smlara/AstroK_Enfocador_Rotador/docs/ESP32-C3-Super-Mini-pinout-low.png

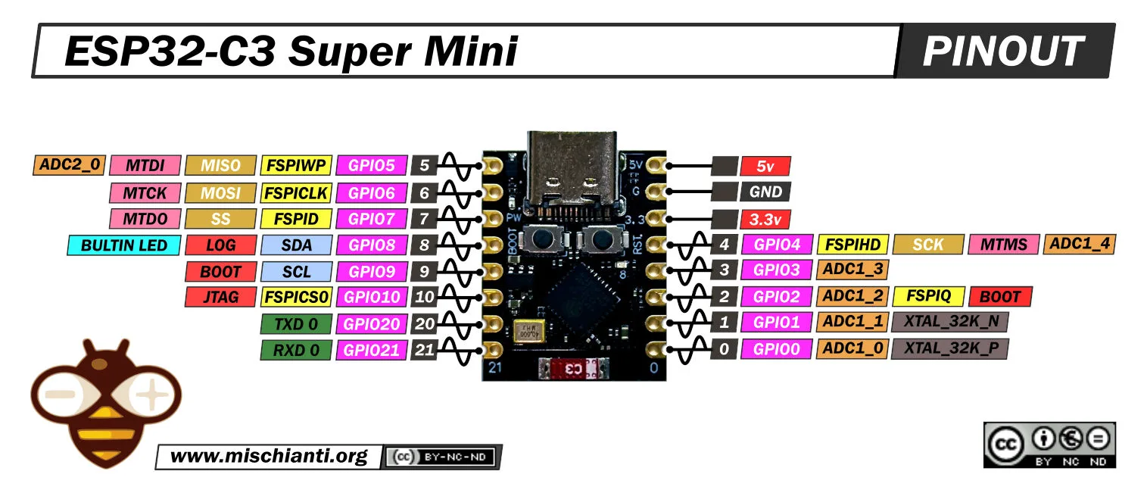
docs/ESP32-C3-Super-Mini-pinout-low.png
