smlara/AstroK_Enfocador_Rotador/pcb/Netlist_Schematic1_2026-05-12.txt

{
    "gge2": {
        "props": {
            "LCSC Part Name": "两相双极步进电机的步进/方向驱动器 - 用于安静运行的StealthChop技术 - 可选UART接口 - 无传感器失速检测 停产",
            "Supplier Part": "C465949",
            "Manufacturer": "TRINAMIC",
            "Manufacturer Part": "TMC2209-LA",
            "Supplier Footprint": "QFN-28-EP(5x5)",
            "JLCPCB Part Class": "Extended Part",
            "Datasheet": "https://item.szlcsc.com/datasheet/TMC2209-LA/471340.html",
            "Supplier": "LCSC",
            "Add into BOM": "yes",
            "Convert to PCB": "yes",
            "3D Model": "9772efdf0dd34d809a718c9d75b277ef",
            "3D Model Title": "TQFN-28_L5.0-W5.0-H0.8-P0.50",
            "3D Model Transform": "197.6374,197.6374,0,90,0,0,-0.003,0.003,0",
            "Control Voltage": "3V~5.5V",
            "Motor Drive Voltage(Vm)": "4.75V~29V",
            "Output Current": "2.8A",
            "Number of H-bridges": "-",
            "Drive Type": "Bipolar Driver",
            "Step Resolution": "256",
            "Interface": "STEP/DIR；UART",
            "Technology": "Yes",
            "RDS(on)": "170mΩ",
            "Operating Temperature": "-40℃~+125℃",
            "Description": "Control Voltage:3V~5.5V Control Voltage:3V~5.5V Motor Drive Voltage(Vm):4.75V~29V Motor Drive Voltage(Vm):4.75V~29V Output Current:2.8A Output Current:2.8A Number of H-bridges:- Drive Type:Bipolar Driver Step Resolution:256 Interface:STEP/DIR；UART Technol",
            "Footprint": "39e8b99baa33449e9cae2089282201de",
            "Symbol": "34beaa57e8774e72a2fe442a596259f5",
            "Designator": "TMC2226",
            "Name": "={Manufacturer Part}",
            "Device": "ca737c85a38643f29cac1c07b95a2e08",
            "Unique ID": "gge2",
            "Reuse Block": "",
            "Group ID": "",
            "Channel ID": "$1e688",
            "FootprintName": "COMM-TH_TMC2226",
            "DeviceName": "TMC2209-LA",
            "SymbolName": "TMC2226 BIGTREETECH"
        },
        "pins": {
            "1": "GND",
            "2": "+3V3",
            "3": "M1B",
            "4": "M1A",
            "5": "M2A",
            "6": "M2B",
            "7": "GND",
            "8": "+12V",
            "9": "DIR",
            "10": "STEP",
            "11": "GND",
            "12": "RX",
            "13": "RX",
            "14": "GND",
            "15": "GND",
            "16": "ENABLE",
            "17": "",
            "18": "DIAG"
        }
    },
    "gge5": {
        "props": {
            "LCSC Part Name": "1x4P 间距:2.5mm 直插 系列:XH",
            "Supplier Part": "C7429634",
            "Manufacturer": "Megastar(兆星)",
            "Supplier Footprint": "插件,P=2.5mm",
            "JLCPCB Part Class": "Extended Part",
            "Datasheet": "https://item.szlcsc.com/datasheet/ZX-XH2.54-4PZZ/8427551.html",
            "Supplier": "LCSC",
            "Add into BOM": "yes",
            "Convert to PCB": "yes",
            "Footprint": "7ed1881608fd41979f52bf67ff7881be",
            "3D Model": "d6f2687bc06b47fb8e014feb06c7c5ec",
            "3D Model Title": "CONN-TH_4P-P2.50_4PIN",
            "3D Model Transform": "492.125,224.409,0,180,0,0,0,17.717,-118.11",
            "Pins Structure": "1x4P",
            "Pitch": "2.5mm",
            "Mounting Type": "Through Hole",
            "Reference Series": "XH",
            "Number of Pins": "4P",
            "Number of Rows": "1",
            "Number of PINs Per Row": "4",
            "Row Spacing": "-",
            "Current Rating": "3A",
            "Contact Material": "Brass",
            "Contact Plating": "Tin",
            "Operating Temperature": "-25℃~+85℃",
            "Voltage Rating": "250V",
            "Plastic Material": "PA66",
            "Flame Retardant Rating": "UL94V-0",
            "Supplementary Features": "-",
            "Color": "White",
            "Z-Height of the Board": "7mm",
            "X-Length of Bottom Edge on Board (Spacing Line)": "12.5mm",
            "Y-Width of Bottom Edge on Board": "5.9mm",
            "Description": "Pins Structure:1x4P Pitch:2.5mm Mounting Type:Through Hole Reference Series:XH Number of Pins:4P Number of Rows:1 Number of PINs Per Row:4 Row Spacing:- Current Rating:3A Contact Material:Brass Contact Plating:Tin Operating Temperature:-25℃~+85℃ Operating",
            "Manufacturer Part": "MOTOR",
            "Symbol": "bc1bf59f1a2644168f54452483cc2da6",
            "Designator": "MOTOR1",
            "Name": "={Manufacturer Part}",
            "Device": "a4ed7870ec324077bd03244d814faef1",
            "Reuse Block": "",
            "Group ID": "",
            "Channel ID": "$1e1275",
            "Unique ID": "gge5",
            "FootprintName": "CONN-TH_4P-P2.50_4PIN",
            "DeviceName": "ZX-XH2.54-4PZZ",
            "SymbolName": "ZX-XH2.54-4PZZ"
        },
        "pins": {
            "1": "M1B",
            "2": "M1A",
            "3": "M2A",
            "4": "M2B"
        }
    },
    "gge6": {
        "props": {
            "LCSC Part Name": "ESP32-S3-Zero",
            "Supplier Part": "C9900152785",
            "Manufacturer": "",
            "Supplier Footprint": "SMD",
            "JLCPCB Part Class": "",
            "Datasheet": "",
            "Supplier": "LCSC",
            "Add into BOM": "yes",
            "Convert to PCB": "yes",
            "Footprint": "0d978b79bd7244b9a51661624b98b371",
            "3D Model": "f293d8f2fa8d48b190d7099c4e132450",
            "3D Model Title": "COMM-SMD_18P-P2.54-L23.5-W18.0-TL",
            "3D Model Transform": "708.66,982.907,0,0,0,0,0,28.661,0",
            "Description": "",
            "Manufacturer Part": "ESP32-C3-Supermini",
            "Symbol": "c2ed76fd3e524481a9557f2733d2aae2",
            "Designator": "ESP32",
            "Name": "={Manufacturer Part}",
            "Device": "0619ef12f6304719bf7143cc2ef1ea14",
            "Reuse Block": "",
            "Group ID": "",
            "Channel ID": "$1e2238",
            "Unique ID": "gge6",
            "FootprintName": "COMM-SMD_18P-P2.54-L23.5-W18.0-TL",
            "DeviceName": "ESP32-S3-Zero",
            "SymbolName": "ESP32-S3-ZERO"
        },
        "pins": {
            "1": "TX",
            "2": "RX",
            "3": "",
            "4": "DIAG",
            "5": "STEP",
            "6": "DIR",
            "7": "ENABLE",
            "8": "SDA",
            "9": "SCL",
            "10": "S1",
            "11": "S2",
            "12": "KEY",
            "13": "MODE",
            "14": "",
            "15": "",
            "16": "+3V3",
            "17": "GND",
            "18": "5V"
        }
    },
    "gge7": {
        "props": {
            "LCSC Part Name": "1x4P 间距:2.5mm 直插 系列:XH",
            "Supplier Part": "C7429634",
            "Manufacturer": "Megastar(兆星)",
            "Supplier Footprint": "插件,P=2.5mm",
            "JLCPCB Part Class": "Extended Part",
            "Datasheet": "https://item.szlcsc.com/datasheet/ZX-XH2.54-4PZZ/8427551.html",
            "Supplier": "LCSC",
            "Add into BOM": "yes",
            "Convert to PCB": "yes",
            "Footprint": "7ed1881608fd41979f52bf67ff7881be",
            "3D Model": "d6f2687bc06b47fb8e014feb06c7c5ec",
            "3D Model Title": "CONN-TH_4P-P2.50_4PIN",
            "3D Model Transform": "492.125,224.409,0,180,0,0,0,17.717,-118.11",
            "Pins Structure": "1x4P",
            "Pitch": "2.5mm",
            "Mounting Type": "Through Hole",
            "Reference Series": "XH",
            "Number of Pins": "4P",
            "Number of Rows": "1",
            "Number of PINs Per Row": "4",
            "Row Spacing": "-",
            "Current Rating": "3A",
            "Contact Material": "Brass",
            "Contact Plating": "Tin",
            "Operating Temperature": "-25℃~+85℃",
            "Voltage Rating": "250V",
            "Plastic Material": "PA66",
            "Flame Retardant Rating": "UL94V-0",
            "Supplementary Features": "-",
            "Color": "White",
            "Z-Height of the Board": "7mm",
            "X-Length of Bottom Edge on Board (Spacing Line)": "12.5mm",
            "Y-Width of Bottom Edge on Board": "5.9mm",
            "Description": "Pins Structure:1x4P Pitch:2.5mm Mounting Type:Through Hole Reference Series:XH Number of Pins:4P Number of Rows:1 Number of PINs Per Row:4 Row Spacing:- Current Rating:3A Contact Material:Brass Contact Plating:Tin Operating Temperature:-25℃~+85℃ Operating",
            "Symbol": "bc1bf59f1a2644168f54452483cc2da6",
            "Designator": "OLED1",
            "Manufacturer Part": "OLED",
            "Name": "={Manufacturer Part}",
            "Device": "a4ed7870ec324077bd03244d814faef1",
            "Reuse Block": "",
            "Group ID": "",
            "Channel ID": "$1e2540",
            "Unique ID": "gge7",
            "FootprintName": "CONN-TH_4P-P2.50_4PIN",
            "DeviceName": "ZX-XH2.54-4PZZ",
            "SymbolName": "ZX-XH2.54-4PZZ"
        },
        "pins": {
            "1": "GND",
            "2": "+3V3",
            "3": "SCL",
            "4": "SDA"
        }
    },
    "gge8": {
        "props": {
            "LCSC Part Name": "1x5P 间距:2.5mm 直插 系列:XH",
            "Supplier Part": "C7429635",
            "Manufacturer": "Megastar(兆星)",
            "Supplier Footprint": "插件,P=2.5mm",
            "JLCPCB Part Class": "Extended Part",
            "Datasheet": "https://item.szlcsc.com/datasheet/ZX-XH2.54-5PZZ/8427552.html",
            "Supplier": "LCSC",
            "Add into BOM": "yes",
            "Convert to PCB": "yes",
            "Footprint": "e2f35c3804834d0988c624fc18600485",
            "3D Model": "9f7cbb6a95224b9c8d31ae071dd0e74a",
            "3D Model Title": "CONN-TH_5P-P2.50_ZX-XH2.54-5PZZ",
            "3D Model Transform": "590.55,232.6767,0,0,0,0,0,14.528,-133.858",
            "Pins Structure": "1x5P",
            "Pitch": "2.5mm",
            "Mounting Type": "Through Hole",
            "Reference Series": "XH",
            "Number of Pins": "5P",
            "Number of Rows": "1",
            "Number of PINs Per Row": "5",
            "Row Spacing": "-",
            "Current Rating": "3A",
            "Contact Material": "Brass",
            "Contact Plating": "Tin",
            "Operating Temperature": "-25℃~+85℃",
            "Voltage Rating": "250V",
            "Plastic Material": "PA66",
            "Flame Retardant Rating": "UL94V-0",
            "Supplementary Features": "-",
            "Color": "White",
            "Z-Height of the Board": "7mm",
            "X-Length of Bottom Edge on Board (Spacing Line)": "15mm",
            "Y-Width of Bottom Edge on Board": "5.9mm",
            "Description": "Pins Structure:1x5P Pitch:2.5mm Mounting Type:Through Hole Reference Series:XH Number of Pins:5P Number of Rows:1 Number of PINs Per Row:5 Row Spacing:- Current Rating:3A Contact Material:Brass Contact Plating:Tin Operating Temperature:-25℃~+85℃ Operating",
            "Symbol": "e7e03ba4e2cb4347ab1d249763134473",
            "Designator": "ENCODER1",
            "Manufacturer Part": "ENCODER",
            "Name": "={Manufacturer Part}",
            "Device": "af8914bd55cd4d059659d83c617bb656",
            "Reuse Block": "",
            "Group ID": "",
            "Channel ID": "$1e2770",
            "Unique ID": "gge8",
            "FootprintName": "CONN-TH_5P-P2.50_ZX-XH2.54-5PZZ",
            "DeviceName": "ZX-XH2.54-5PZZ",
            "SymbolName": "ZX-XH2.54-5PZZ"
        },
        "pins": {
            "1": "GND",
            "2": "KEY",
            "3": "S2",
            "4": "S1",
            "5": "+3V3"
        }
    },
    "gge9": {
        "props": {
            "LCSC Part Name": "1x4P 间距:2.5mm 直插 系列:XH",
            "Supplier Part": "C7429634",
            "Manufacturer": "Megastar(兆星)",
            "Supplier Footprint": "插件,P=2.5mm",
            "JLCPCB Part Class": "Extended Part",
            "Datasheet": "https://item.szlcsc.com/datasheet/ZX-XH2.54-4PZZ/8427551.html",
            "Supplier": "LCSC",
            "Add into BOM": "yes",
            "Convert to PCB": "yes",
            "Footprint": "7ed1881608fd41979f52bf67ff7881be",
            "3D Model": "d6f2687bc06b47fb8e014feb06c7c5ec",
            "3D Model Title": "CONN-TH_4P-P2.50_4PIN",
            "3D Model Transform": "492.125,224.409,0,180,0,0,0,17.717,-118.11",
            "Pins Structure": "1x4P",
            "Pitch": "2.5mm",
            "Mounting Type": "Through Hole",
            "Reference Series": "XH",
            "Number of Pins": "4P",
            "Number of Rows": "1",
            "Number of PINs Per Row": "4",
            "Row Spacing": "-",
            "Current Rating": "3A",
            "Contact Material": "Brass",
            "Contact Plating": "Tin",
            "Operating Temperature": "-25℃~+85℃",
            "Voltage Rating": "250V",
            "Plastic Material": "PA66",
            "Flame Retardant Rating": "UL94V-0",
            "Supplementary Features": "-",
            "Color": "White",
            "Z-Height of the Board": "7mm",
            "X-Length of Bottom Edge on Board (Spacing Line)": "12.5mm",
            "Y-Width of Bottom Edge on Board": "5.9mm",
            "Description": "Pins Structure:1x4P Pitch:2.5mm Mounting Type:Through Hole Reference Series:XH Number of Pins:4P Number of Rows:1 Number of PINs Per Row:4 Row Spacing:- Current Rating:3A Contact Material:Brass Contact Plating:Tin Operating Temperature:-25℃~+85℃ Operating",
            "Symbol": "bc1bf59f1a2644168f54452483cc2da6",
            "Designator": "TEMP1",
            "Manufacturer Part": "TEMP",
            "Name": "={Manufacturer Part}",
            "Device": "a4ed7870ec324077bd03244d814faef1",
            "Reuse Block": "",
            "Group ID": "",
            "Channel ID": "$1e3036",
            "Unique ID": "gge9",
            "FootprintName": "CONN-TH_4P-P2.50_4PIN",
            "DeviceName": "ZX-XH2.54-4PZZ",
            "SymbolName": "ZX-XH2.54-4PZZ"
        },
        "pins": {
            "1": "GND",
            "2": "+3V3",
            "3": "SCL",
            "4": "SDA"
        }
    },
    "gge10": {
        "props": {
            "LCSC Part Name": "DC电源插座 内径:2mm 外径:6.3mm",
            "Supplier Part": "C22459640",
            "Manufacturer": "HanElectricity(瀚源)",
            "Manufacturer Part": "DC-005-2.0",
            "Supplier Footprint": "插件",
            "JLCPCB Part Class": "Extended Part",
            "Datasheet": "https://item.szlcsc.com/datasheet/DC-005-2.0/24136246.html",
            "Supplier": "LCSC",
            "Add into BOM": "yes",
            "Convert to PCB": "yes",
            "Footprint": "81bc1093124949018fd0e79b9432e0fa",
            "3D Model": "7581ff9d220f40e997ce41ca63128218",
            "3D Model Title": "DC-IN-TH_DC-005-2.0_C22459640",
            "3D Model Transform": "559.054,372.08587,0,0,0,0,-139.763,86.614,-157.48",
            "Connector Type": "DC Power Jack",
            "Mounting Type": "Right Angle",
            "Inside Contact Diameter": "2mm",
            "Outside Contact Diameter": "6.3mm",
            "Current Rating": "3A",
            "Voltage Rating (Max)": "20V",
            "Description": "Connector Type:DC Power Jack Mounting Type:Right Angle Inside Contact Diameter:2mm Outside Contact Diameter:6.3mm Current Rating:3A Voltage Rating (Max):20V",
            "Symbol": "1d50c0a19d5f4e1a87743400066d0d2e",
            "Designator": "VIN12",
            "Name": "={Manufacturer Part}",
            "Device": "fca4f172750b4672a21429a75ad3ce45",
            "Reuse Block": "",
            "Group ID": "",
            "Channel ID": "$1e3109",
            "Unique ID": "gge10",
            "FootprintName": "DC-IN-TH_DC-005-2.0_C22459640",
            "DeviceName": "DC-005-2.0_C22459640",
            "SymbolName": "DC-005-2.0_C22459640"
        },
        "pins": {
            "1": "+12V",
            "2": "GND",
            "3": "GND"
        }
    },
    "gge12": {
        "props": {
            "LCSC Part Name": "10Ω ±5% 100mW 厚膜电阻",
            "Supplier Part": "",
            "Manufacturer": "FOJAN(富捷)",
            "Manufacturer Part": "FRC0603J100 TS",
            "Supplier Footprint": "0603",
            "JLCPCB Part Class": "Extended Part",
            "Datasheet": "",
            "Supplier": "LCSC",
            "Add into BOM": "yes",
            "Convert to PCB": "yes",
            "Footprint": "68f8d034110b4bae8bf82af79a7187e0",
            "3D Model": "112863783b5b41f1b5254f87eedc7932",
            "3D Model Title": "R0603",
            "3D Model Transform": "31.8897,63.7794,0,90,0,0,0,0,0",
            "Type": "Thick Film Resistor",
            "Value": "1kΩ",
            "Tolerance": "±5%",
            "Voltage-Supply(Max)": "75V",
            "Power(Watts)": "100mW",
            "Temperature Coefficient": "±100ppm/℃",
            "Operating Temperature": "-55℃~+155℃",
            "Symbol": "765048fcc482431baba044d299f570c6",
            "Description": "Type:Thick Film Resistor Resistance:10Ω Tolerance:±5% Tolerance:±5% Power(Watts):100mW Voltage-Supply(Max):75V Temperature Coefficient:±100ppm/℃ Temperature Coefficient:±100ppm/℃ Operating Temperature:-55℃~+155℃ Operating Temperature:-55℃~+155℃ ",
            "Designator": "R1",
            "Name": "={Value}",
            "Device": "af8d8b2aebfb4a6a970aadbd1c22fdce",
            "Unique ID": "gge12",
            "FootprintName": "R0603",
            "DeviceName": "FRC0603J100 TS",
            "SymbolName": "Res",
            "Group ID": "",
            "Channel ID": "$1e3257",
            "Reuse Block": ""
        },
        "pins": {
            "1": "+3V3",
            "2": "SCL"
        }
    },
    "gge13": {
        "props": {
            "LCSC Part Name": "10Ω ±5% 100mW 厚膜电阻",
            "Supplier Part": "",
            "Manufacturer": "FOJAN(富捷)",
            "Manufacturer Part": "FRC0603J100 TS",
            "Supplier Footprint": "0603",
            "JLCPCB Part Class": "Extended Part",
            "Datasheet": "",
            "Supplier": "LCSC",
            "Add into BOM": "yes",
            "Convert to PCB": "yes",
            "Footprint": "68f8d034110b4bae8bf82af79a7187e0",
            "3D Model": "112863783b5b41f1b5254f87eedc7932",
            "3D Model Title": "R0603",
            "3D Model Transform": "31.8897,63.7794,0,90,0,0,0,0,0",
            "Type": "Thick Film Resistor",
            "Value": "4.7kΩ",
            "Tolerance": "±5%",
            "Voltage-Supply(Max)": "75V",
            "Power(Watts)": "100mW",
            "Temperature Coefficient": "±100ppm/℃",
            "Operating Temperature": "-55℃~+155℃",
            "Symbol": "765048fcc482431baba044d299f570c6",
            "Description": "Type:Thick Film Resistor Resistance:10Ω Tolerance:±5% Tolerance:±5% Power(Watts):100mW Voltage-Supply(Max):75V Temperature Coefficient:±100ppm/℃ Temperature Coefficient:±100ppm/℃ Operating Temperature:-55℃~+155℃ Operating Temperature:-55℃~+155℃ ",
            "Designator": "R2",
            "Name": "={Value}",
            "Device": "af8d8b2aebfb4a6a970aadbd1c22fdce",
            "Unique ID": "gge13",
            "FootprintName": "R0603",
            "DeviceName": "FRC0603J100 TS",
            "SymbolName": "Res",
            "Group ID": "",
            "Channel ID": "$1e3281",
            "Reuse Block": ""
        },
        "pins": {
            "1": "+3V3",
            "2": "SDA"
        }
    },
    "gge14": {
        "props": {
            "LCSC Part Name": "10Ω ±5% 100mW 厚膜电阻",
            "Supplier Part": "",
            "Manufacturer": "FOJAN(富捷)",
            "Manufacturer Part": "FRC0603J100 TS",
            "Supplier Footprint": "0603",
            "JLCPCB Part Class": "Extended Part",
            "Datasheet": "",
            "Supplier": "LCSC",
            "Add into BOM": "yes",
            "Convert to PCB": "yes",
            "Footprint": "68f8d034110b4bae8bf82af79a7187e0",
            "3D Model": "112863783b5b41f1b5254f87eedc7932",
            "3D Model Title": "R0603",
            "3D Model Transform": "31.8897,63.7794,0,90,0,0,0,0,0",
            "Type": "Thick Film Resistor",
            "Value": "1kΩ",
            "Tolerance": "±5%",
            "Voltage-Supply(Max)": "75V",
            "Power(Watts)": "100mW",
            "Temperature Coefficient": "±100ppm/℃",
            "Operating Temperature": "-55℃~+155℃",
            "Designator": "R3",
            "Symbol": "765048fcc482431baba044d299f570c6",
            "Name": "={Value}",
            "Description": "Type:Thick Film Resistor Resistance:10Ω Tolerance:±5% Tolerance:±5% Power(Watts):100mW Voltage-Supply(Max):75V Temperature Coefficient:±100ppm/℃ Temperature Coefficient:±100ppm/℃ Operating Temperature:-55℃~+155℃ Operating Temperature:-55℃~+155℃ ",
            "Device": "af8d8b2aebfb4a6a970aadbd1c22fdce",
            "Unique ID": "gge14",
            "FootprintName": "R0603",
            "DeviceName": "FRC0603J100 TS",
            "SymbolName": "Res",
            "Group ID": "",
            "Channel ID": "$1e4000",
            "Reuse Block": ""
        },
        "pins": {
            "1": "TX",
            "2": "RX"
        }
    },
    "gge15": {
        "props": {
            "Footprint": "706c8188c32d47f58e7ca2d806fcb658",
            "Supplier": "LCSC",
            "Manufacturer": "AISHI(艾华集团)",
            "Manufacturer Part": "ERS1EM101E11OT",
            "Value": "100uF",
            "Supplier Part": "C112509",
            "JLCPCB Part Class": "Extended Part",
            "LCSC Part Name": "100uF ±20% 25V",
            "Supplier Footprint": "插件,D6.3xL11mm",
            "Datasheet": "https://item.szlcsc.com/datasheet/ERS1EM101E11OT/113742.html",
            "Add into BOM": "yes",
            "Convert to PCB": "yes",
            "3D Model": "b565ea104e684643a82bac9b1c8da51e",
            "3D Model Title": "CAP-TH_BD6.3-P2.50-D1.0-FD",
            "3D Model Transform": "248.4247,247.99777,0,0,0,0,0,0,-137.795",
            "Tolerance": "±20%",
            "Voltage Rating": "25V",
            "Pin Spacing": "2.5mm",
            "Diameter": "6.3mm",
            "Height - Seated (Max)": "11mm",
            "Lifetime": "5000hrs@105℃",
            "Description": "Capacitance:100uF Tolerance:±20% Tolerance:±20% Voltage Rating:25V Pin Spacing:2.5mm Diameter:6.3mm Height - Seated (Max):11mm Lifetime:5000hrs@105℃",
            "Symbol": "28aa7e503e074152a6da410b7a149f4a",
            "Designator": "C1",
            "Name": "={Value}",
            "Device": "8eefc1eb6d074fcfa231a25649834734",
            "Reuse Block": "",
            "Group ID": "",
            "Channel ID": "$1e4139",
            "Unique ID": "gge15",
            "FootprintName": "CAP-TH_BD6.3-P2.50-D1.0-FD",
            "DeviceName": "ERS1EM101E11OT",
            "SymbolName": "ERS1EM101E11OT"
        },
        "pins": {
            "1": "+12V",
            "2": "GND"
        }
    },
    "gge16": {
        "props": {
            "LCSC Part Name": "1x2P 间距:2.54mm 方针 直插",
            "Supplier Part": "C52016390",
            "Manufacturer": "hanxia(韩下)",
            "Manufacturer Part": "HX PH254-01-02-Z-L11.5 male header connector",
            "Supplier Footprint": "插件,P=2.54mm",
            "JLCPCB Part Class": "Extended Part",
            "Datasheet": "https://item.szlcsc.com/datasheet/HX%2520PH254-01-02-Z-L11.5%2520male%2520header%2520connector/54760435.html",
            "Supplier": "LCSC",
            "Add into BOM": "yes",
            "Convert to PCB": "yes",
            "Footprint": "1c2716e47b4543f7b4ec3a03e3c7d65c",
            "3D Model": "b9a02bffb1e248eabf92e8e2aa859dc0",
            "3D Model Title": "HDR2.54-M-LI-1X2P",
            "3D Model Transform": "200,100,0,0,0,0,0,0,-118.11",
            "Pin Structure": "1x2P",
            "Pitch": "2.54mm",
            "Circluar Pins/Square Pins": "Pin Header",
            "Mounting Type": "Through Hole",
            "Number of Rows": "1",
            "Number of Pins": "2P",
            "Current Rating": "3A",
            "Voltage Rating (Max)": "1kV",
            "Length of Mating Pin": "6mm",
            "Insulation Height": "2.5mm",
            "Length of End Connection Pin": "3mm",
            "Contact Material": "Brass",
            "Contact Plating": "Gold",
            "Operating Temperature": "-40℃~+105℃",
            "Description": "Pin Structure:1x2P Pitch:2.54mm Circluar Pins/Square Pins:Pin Header Mounting Type:Through Hole Number of Rows:1 Number of Pins:2P Current Rating:3A Voltage Rating (Max):1kV Length of Mating Pin:6mm Insulation Height:2.5mm Length of End Connection Pin:3mm",
            "Symbol": "4ecff2602de84c2cbe9e22612c42ac53",
            "Designator": "MODE1",
            "Name": "={Manufacturer Part}",
            "Device": "2571054643fb4547be3b9a5228520ca0",
            "Unique ID": "gge16",
            "Reuse Block": "",
            "Group ID": "",
            "Channel ID": "$1e4898",
            "FootprintName": "HDR-TH_2P-P2.54-V-M",
            "DeviceName": "HX PH254-01-02-Z-L11.5 male header connector",
            "SymbolName": "HX PH254-01-02-Z-L11.5 MALE HEADER CONNECTOR"
        },
        "pins": {
            "1": "GND",
            "2": "MODE"
        }
    },
    "gge17": {
        "props": {
            "LCSC Part Name": "FEP16GT-E3/45",
            "Supplier Part": "C3008992",
            "Manufacturer": "VISHAY(威世)",
            "Manufacturer Part": "FEP16GT-E3/45",
            "Supplier Footprint": "TO-220-3",
            "JLCPCB Part Class": "Extended Part",
            "Datasheet": "https://atta.szlcsc.com/upload/public/pdf/source/20230201/E038E7B429758093516B122B00E73072.pdf",
            "Supplier": "LCSC",
            "Add into BOM": "yes",
            "Convert to PCB": "yes",
            "Footprint": "b2a032bca3fc47249b0332f6c10782db",
            "3D Model": "8a57f658127440348bf9aaf92df835b4",
            "3D Model Title": "TO-220-3_L10.2-W4.6-P2.54-L",
            "3D Model Transform": "399.999,177.204,0,0,0,0,0,24.606,-196.85",
            "Description": "",
            "Symbol": "33bf90b824d04c56b988a0db85bed240",
            "Designator": "REG5",
            "Name": "={Manufacturer Part}",
            "Device": "65cfced14a23457cb8ab2865d8424d3b",
            "Unique ID": "gge17",
            "Reuse Block": "",
            "Group ID": "",
            "Channel ID": "$1e5612",
            "FootprintName": "TO-220-3_L10.2-W4.6-P2.54-L",
            "DeviceName": "FEP16GT-E3/45",
            "SymbolName": "HX PH254-01-03-Z-L11.5 PCB PIN HEADER"
        },
        "pins": {
            "1": "+12V",
            "2": "GND",
            "3": "5V"
        }
    }
}
