smlara/AstroK_Enfocador_Rotador/pcb/BOM_PCB Base_PCB2_1_2026-09-02.xlsx

No. | Quantity | Comment | Designator | Footprint | Value | Manufacturer Part | Manufacturer | Supplier Part | Supplier
1 | 1 | 100uF | C1 | CAP-SMD_BD6.3-L6.6-W6.6-LS7.2-FD-1 | 100uF | RVT1E101M0607 100UF 25V | DMBJ(振宝佳) | C970685 | LCSC
2 | 1 | 10uF | C2 | C0805 | 10uF | CC0805KKX5R8BB106 | YAGEO(国巨) | C694803 | LCSC
3 | 3 | 100nF | C3,C4,C5 | C0603 | 100nF | CC0603X7R50V104KN | TORCH(火炬) | C53084449 | LCSC
4 | 1 | ENCODER | ENCODER1 | CONN-TH_5P-P2.50_ZX-XH2.54-5PZZ |  | ENCODER | Megastar(兆星) | C7429635 | LCSC
5 | 1 | ESP32-C3 SuperMini_TH | ESP32C3 | COMM-TH_ESP32-C3-SUPERMINI_TH |  | ESP32-C3 SuperMini_TH |  | C9900278769 | LCSC
6 | 1 | HX PH254-01-02-Z-L11.5 male header connector | MODE1 | HDR-TH_2P-P2.54-V-M |  | HX PH254-01-02-Z-L11.5 male header connector | hanxia(韩下) | C52016390 | LCSC
7 | 1 | MOTOR | MOTOR1 | CONN-TH_4P-P2.50_4PIN |  | MOTOR | Megastar(兆星) | C7429634 | LCSC
8 | 1 | OLED | OLED1 | CONN-TH_4P-P2.50_4PIN |  | OLED | Megastar(兆星) | C7429634 | LCSC
9 | 1 | 1kΩ | R3 | R0603 | 1kΩ | CR0603FA1001G | LIZ(丽智电子) | C126900 | LCSC
10 | 1 | 10kΩ | R4 | R0603 | 10kΩ | SCR0603J10K | VO(翔胜) | C3017715 | LCSC
11 | 1 | 7805 | REG | TO-220-3_L10.0-W4.5-P2.54-L-1 |  | 7805 | luJing(鲁晶) | C53058822 | LCSC
12 | 1 | TMC2209-LA | TMC2209 | COMM-TH_TMC2226 |  | TMC2209-LA | TRINAMIC | C465949 | LCSC
13 | 1 | DC-005-2.0 | VIN12 | DC-IN-TH_DC-005-2.0_C22459640 |  | DC-005-2.0 | HanElectricity(瀚源) | C22459640 | LCSC
