smlara/AstroK_Enfocador_Rotador/pcb/RasmaMoonlitePCB.step

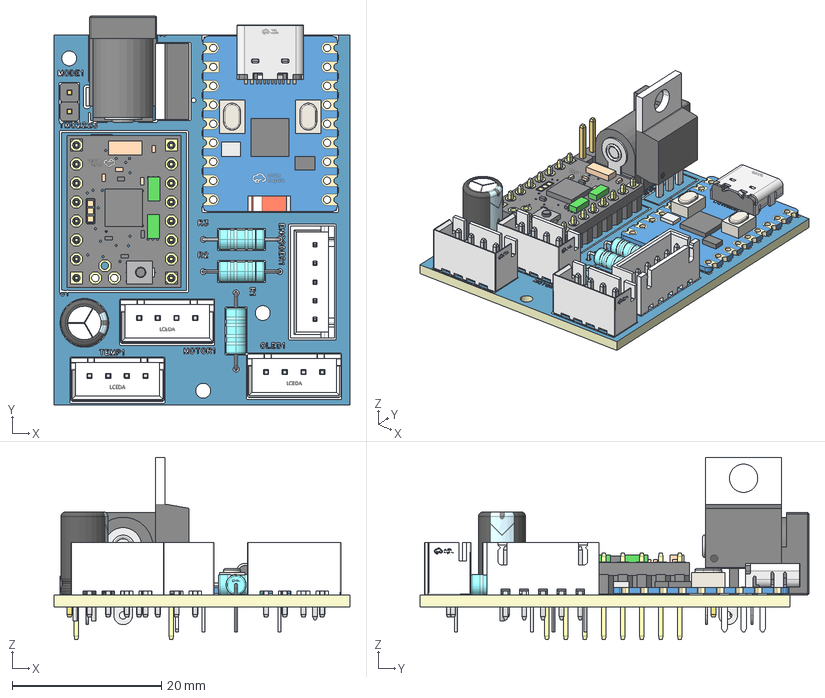
[picture p2: CAD file, 2026-10-29]
pcb/RasmaMoonlitePCB.step
39.6 x 52.0 x 24.4 mm
Board~QuEb
TopCopper~QuEb
BottomCopper~QuEb
TopSilkscreen~QuEb
TopFpcStiffener~QuEb
BottomFpcStiffener~QuEb
CAP-TH_BD6.3-P2.50-D1.0-FD~CAP-TH_BD6.3-P2.50-D1.0-FD~QuEb
HDR-TH_2P-P2.54-V-M~HDR2.54-M-LI-1X2P~QuEb
TO-220-3_L10.2-W4.6-P2.54-L~TO-220-3_L10.2-W4.6-P2.54-L~QuEb
RES-TH_BD2.7-L6.2-P10.20-D0.4~RES-TH_BD2.7-L6.2-P10.20-D0.4~QuEb x 3
CONN-TH_4P-P2.50_4PIN~CONN-TH_4P-P2.50_4PIN~QuEb x 3
CONN-TH_5P-P2.50_ZX-XH2.54-5PZZ~CONN-TH_5P-P2.50_ZX-XH2.54-5PZZ~QuEb
DC-IN-TH_DC-005-2.0_C22459640~DC-IN-TH_DC-005-2.0_C22459640~QuEb
COMM-TH_TMC2209SILENTSTEPSTICK~COMM-TH_TMC2209SILENTSTEPSTICK~QuEb
COMM-SMD_18P-P2.54-L23.5-W18.0-TL~COMM-SMD_ 18P-P2.54-L23.5-W18.0-TL~QuEb
