smlara/AstroK_Enfocador_Rotador/pcb/AstroKRotadorEnfocador.step

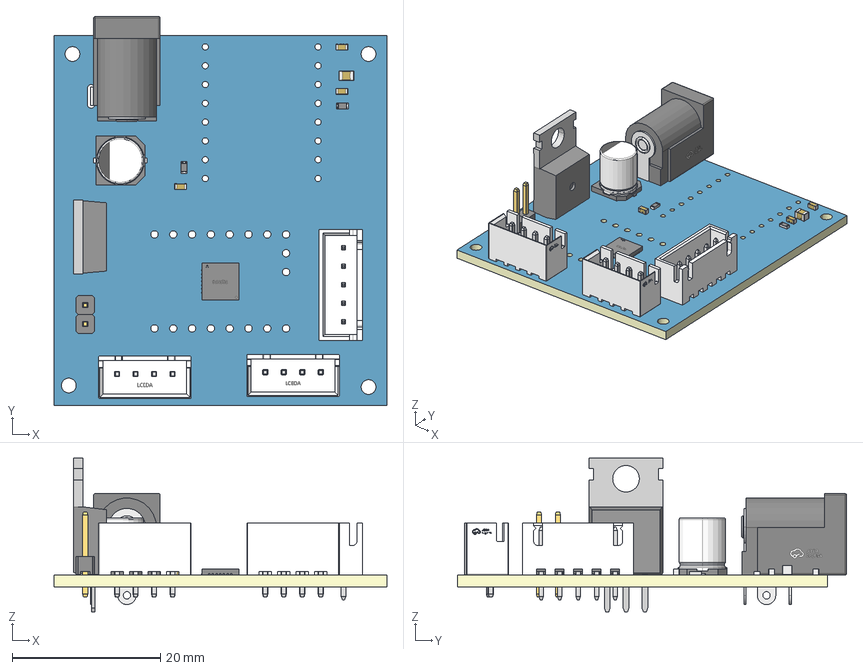
[picture p3: CAD file, 2026-10-29]
pcb/AstroKRotadorEnfocador.step
45.0 x 52.6 x 20.8 mm
Board~19T6
TopCopper~19T6
BottomCopper~19T6
TopFpcStiffener~19T6
BottomFpcStiffener~19T6
TO-220-3_L10.0-W4.5-P2.54-L-1~TO-220-3_L10.0-W4.5-P2.54-L-1~19T6
C0603~C0603_L1.6-W0.8-H0.8~19T6 x 3
C0805~C0805_L2.0-W1.3-H1.3~19T6
R0603~R0603~19T6 x 2
HDR-TH_2P-P2.54-V-M~HDR2.54-M-LI-1X2P~19T6
CONN-TH_5P-P2.50_ZX-XH2.54-5PZZ~CONN-TH_5P-P2.50_ZX-XH2.54-5PZZ~19T6
CONN-TH_4P-P2.50_4PIN~CONN-TH_4P-P2.50_4PIN~19T6 x 2
CAP-SMD_BD6.3-L6.6-W6.6-LS7.2-FD-1~CAP-SMD_ BD6.3-L6.6-W6.6-LS7.2-FD-1~19T6
COMM-TH_TMC2226~TQFN-28_L5.0-W5.0-H0.8-P0.50~19T6
DC-IN-TH_DC-005-2.0_C22459640~DC-IN-TH_DC-005-2.0_C22459640~19T6
