smlara/AstroK_Enfocador_Rotador/pcb/OLED.step

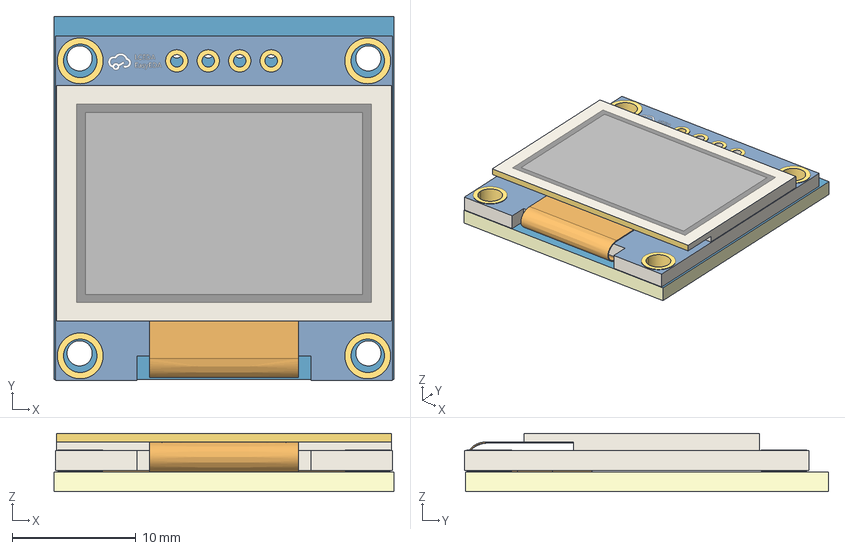
[picture p4: CAD file, 2026-10-29]
pcb/OLED.step
27.4 x 29.4 x 4.72 mm
Board~ehiI
TopCopper~ehiI
BottomCopper~ehiI
TopFpcStiffener~ehiI
BottomFpcStiffener~ehiI
OLED-TH_L27.8-W27.2-P2.54_C9900033791~OLED-TH_L27.8-W27.2-P2.54_ C9900033791~ehiI
