smlara/AstroK_Enfocador_Rotador/src/Config.h

#define CONFIG_H
#include <Arduino.h>
extern bool isRotator;
extern bool rotatorReverse;
extern long maxSpeedGlobal;
extern long accelerationGlobal;
#define MIN_MOTOR_SPEED 100
#define MAX_MOTOR_SPEED 10000
#define MIN_MOTOR_ACCEL 100
#define MAX_MOTOR_ACCEL 20000
#ifdef MOTOR_35BY48
#define DEFAULT_FOCUSER_MICROSTEPS 1
#define DEFAULT_FOCUSER_CURRENT_MA 150
#define DEFAULT_FOCUSER_HOLD_CURRENT_MA 0
#define DEFAULT_FOCUSER_STALL_THRESHOLD 0
#define DEFAULT_FOCUSER_MAX_SPEED 300
#define DEFAULT_FOCUSER_ACCELERATION 150
#define DEFAULT_ROTATOR_MICROSTEPS 8
#define DEFAULT_ROTATOR_STEPS_PER_DEGREE 128.0
#define DEFAULT_ROTATOR_CURRENT_MA 150
#define DEFAULT_ROTATOR_HOLD_CURRENT_MA 0
#define DEFAULT_ROTATOR_STALL_THRESHOLD 0
#define DEFAULT_ROTATOR_MAX_SPEED 1600
#define DEFAULT_ROTATOR_ACCELERATION 800
#endif
#define DEFAULT_FOCUSER_STALL_MIN_SPEED 400
#define DEFAULT_ROTATOR_STALL_MIN_SPEED 300
extern long stallMinSpeedGlobal;
extern uint8_t stallThresholdGlobal;
#define STALL_SETTLE_MS 400
#define STALL_TRUST_FACTOR 2
#define STALL_CONFIRM_MS 30
#define TMC_INTERNAL_CLOCK 12000000UL
extern float stepsPerDegreeGlobal;
#define PASOS_POR_GRADO stepsPerDegreeGlobal
extern long max_steps_global;
#define PASOS_MAXIMOS max_steps_global
#define PASOS_MINIMOS -1000
#define POSICION_CENTRAL 0L
#define CONTROL_CON_BOTONES 1
#define BOTON_ANTIRREBOTE_MS 30
#define BOTON_REPETIR_INICIO_MS 500
#define BOTON_REPETIR_CADA_MS 150
#define TMC_SERIAL_PORT Serial1
#define TMC_R_SENSE 0.11f
#define TMC_ADDRESS 0
#define DEFAULT_FOCUSER_HOLD true
#ifndef DEFAULT_FOCUSER_CURRENT_MA
#define DEFAULT_FOCUSER_CURRENT_MA 400
#endif
#ifndef DEFAULT_FOCUSER_HOLD_CURRENT_MA
#define DEFAULT_FOCUSER_HOLD_CURRENT_MA 200
#endif
#ifndef DEFAULT_FOCUSER_MICROSTEPS
#define DEFAULT_FOCUSER_MICROSTEPS 4
#endif
#define DEFAULT_FOCUSER_REVERSE false
#ifndef DEFAULT_FOCUSER_STALL_THRESHOLD
#define DEFAULT_FOCUSER_STALL_THRESHOLD 100
#endif
#define MAX_FOCUSER_STEPS 999999L
#define DEFAULT_FOCUSER_MAX_STEPS 999999
#define DEFAULT_FOCUSER_FINE_STEP 100
#define DEFAULT_FOCUSER_COARSE_STEP 1000
#ifndef DEFAULT_FOCUSER_MAX_SPEED
#define DEFAULT_FOCUSER_MAX_SPEED 2500
#endif
#ifndef DEFAULT_FOCUSER_ACCELERATION
#define DEFAULT_FOCUSER_ACCELERATION 1000
#endif
#define DEFAULT_ROTATOR_HOLD true
#ifndef DEFAULT_ROTATOR_CURRENT_MA
#define DEFAULT_ROTATOR_CURRENT_MA 800
#endif
#ifndef DEFAULT_ROTATOR_HOLD_CURRENT_MA
#define DEFAULT_ROTATOR_HOLD_CURRENT_MA 200
#endif
#ifndef DEFAULT_ROTATOR_MICROSTEPS
#define DEFAULT_ROTATOR_MICROSTEPS 8
#endif
#define DEFAULT_ROTATOR_REVERSE false
#ifndef DEFAULT_ROTATOR_STALL_THRESHOLD
#define DEFAULT_ROTATOR_STALL_THRESHOLD 16
#endif
#ifndef DEFAULT_ROTATOR_STEPS_PER_DEGREE
#define DEFAULT_ROTATOR_STEPS_PER_DEGREE 37.75
#endif
#define DEFAULT_ROTATOR_FINE_STEP 1.0
#define DEFAULT_ROTATOR_COARSE_STEP 10.0
#ifndef DEFAULT_ROTATOR_MAX_SPEED
#define DEFAULT_ROTATOR_MAX_SPEED 2000
#endif
#ifndef DEFAULT_ROTATOR_ACCELERATION
#define DEFAULT_ROTATOR_ACCELERATION 1000
#endif
#define DEFAULT_WIFI_ENABLED true
#define DEFAULT_WIFI_TIMEOUT_MS 1000
#define DEFAULT_WIFI_RETRIES 10
#define DEFAULT_WIFI_AP_NAME ""
#define DEFAULT_WIFI_AP_PASSWORD "12345678"
#define DEFAULT_BLE_ENABLED true
#define ERR_LFS_MOUNT 1
#define ERR_NVS_PARSE 2
#define EEPROM_ADDR 0
#define SAVE_DELAY_MS 2000
#define SERIAL_BAUD 115200
#if defined(ARDUINO_ESP32_C3)
  #define PIN_STEP 5
  #define PIN_DIR 6
  #define PIN_ENA 7
  #define TMC_UART_TX 21
  #define TMC_UART_RX 20
  #define TMC_DIAG_PIN 10
  #define PIN_SDA 8
  #define PIN_SCL 9
  #define PIN_ENC_S1 1
  #define PIN_ENC_S2 3
  #define PIN_ENC_SW 0
  #define PIN_MODE_SELECTOR 4
#else
  #define PIN_STEP 3
  #define PIN_DIR 4
  #define PIN_ENA 5
  #define TMC_UART_TX 43
  #define TMC_UART_RX 44
  #define TMC_DIAG_PIN 2
  #define PIN_SDA 6
  #define PIN_SCL 7
  #define PIN_ENC_S1 8
  #define PIN_ENC_S2 9
  #define PIN_ENC_SW 10
  #define PIN_MODE_SELECTOR 11
#endif
