smlara/AstroK_Enfocador_Rotador/(commit log)

2026-10-29 AstroK focuser and rotator controller
    Firmware 1.4.3 (ESP32-C3 + TMC2209), ASCOM driver and configuration
    app 2.0.1, device web setup page and PCB design.
    [AstroKRotadorEnfocador.step, BOM_PCB Base_PCB2_1_2026-09-02.xlsx, OLED.step, RasmaMoonlitePCB.step]
2026-10-30 Back to a 6-digit Bluetooth pairing PIN
2026-10-30 Bluetooth access by 4-digit PIN instead of Windows pairing
    Windows pairing kept failing on some boards. The device now keeps a
    4-digit PIN in NVS: over Bluetooth every command answers ER:PIN until
    :BA<pin># is given, the first connection to a device without PIN sets
    it, and 3 wrong PINs drop the connection. USB never asks for it and can
    show, change or clear it (:BP#, :BR#). The app stores the PIN per
    device for itself and the ASCOM driver, asks for it when missing or
    rejected, and has a Bluetooth PIN button in the WiFi / Bluetooth tab.
    [AlpacaServer.cpp, BleLink.cpp, BleLink.h, FocuserProtocol.cpp, FocuserProtocol.h, main.cpp]
2026-10-30 INDI drivers for the focuser and rotator over USB and Bluetooth LE
    indi_astrok_focuser and indi_astrok_rotator (INDI 2.x) speak the same
    serial protocol as the ASCOM driver. USB is opened directly with DTR and
    RTS raised together, since INDI's serial connection resets the C3; BLE
    goes through BlueZ over D-Bus with the device's 4-digit PIN. Motor,
    WiFi, Bluetooth PIN, reboot, factory reset and firmware update are
    exposed as properties and stored on the device.
    [astrok_ble.cpp, astrok_ble.h, astrok_canal.cpp, astrok_canal.h, astrok_comun.cpp, astrok_comun.h, astrok_equipo.cpp, astrok_equipo.h]
2026-10-30 Package the INDI drivers as a .deb for publishing
    scripts/build_indi.ps1 builds indi-astrok_<x.y.z>_<arch>.deb on the
    target machine over SSH and drops it in bin/, and fw.php lists it under
    a new 'indi' key. The INDI drivers get their own version in CMake, used
    for DRIVER_VERSION, the driver list XML and the package.
2026-10-30 Fix the INDI package build over SSH and declare libindi1
    build_indi.ps1 sends the remote script as an LF file, since PowerShell 5.1
    strips double quotes from native arguments, and makes the sources
    writable after extracting them (Windows tar stores read-only dirs).
    libindi1 ships no shlibs file, so dpkg-shlibdeps cannot add it.
2026-10-30 Start INDI drivers 1.0.1
2026-11-01 OLED turns off after the first minute and wakes on movement, encoder or a notice
    Notices (STOP, STALL!, RESET POS., boot errors) stay on screen until the
    encoder is touched or a new movement starts.
    [ExternalDisplay.cpp, ExternalDisplay.h, ManualEncoder.cpp, ManualEncoder.h, main.cpp]
