smlara/AstroK_Enfocador_Rotador/(notices)

Notices in the files:
README.md:
License: GPL v3
License: CERN OHL v2-S
